ap-tech/Drivetrain/Drivetrain pics/323344108_1329896334519297_8781815676884146256_n.jpg

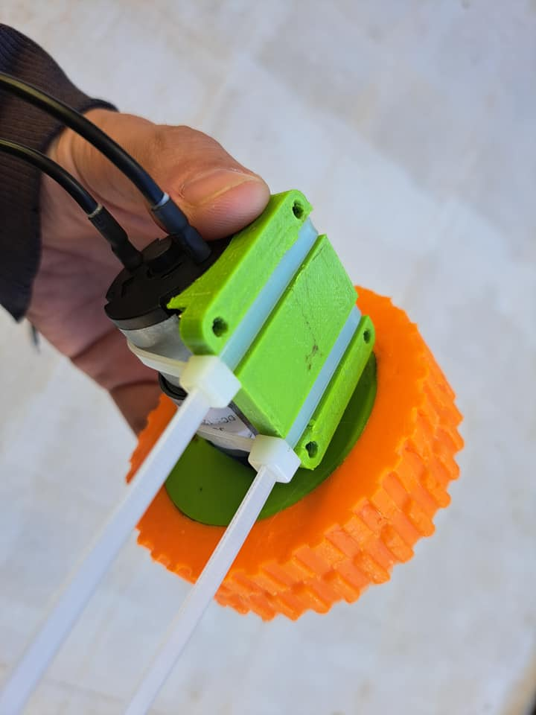
Drivetrain pics/323344108_1329896334519297_8781815676884146256_n.jpg
