ap-tech/Drivetrain/Drivetrain pics/325758844_697571495158825_5226416326378627529_n.jpg

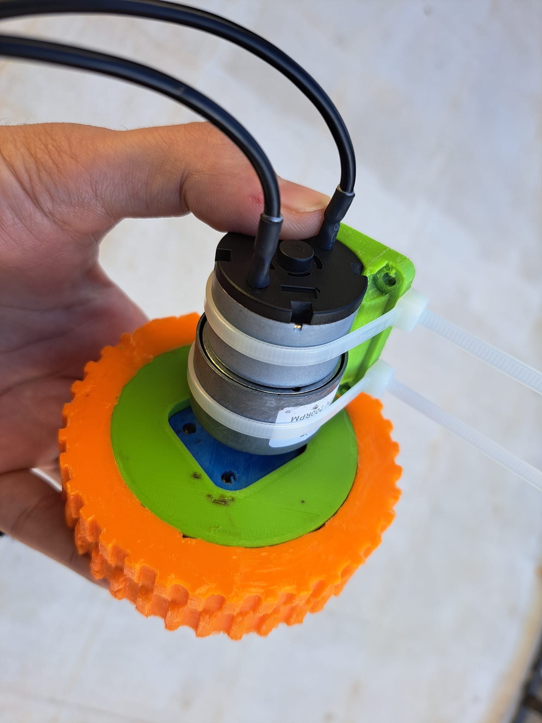
Drivetrain pics/325758844_697571495158825_5226416326378627529_n.jpg
