ap-tech/Drivetrain/Slicer settings and part orientation pics/Cor_Cap.jpg

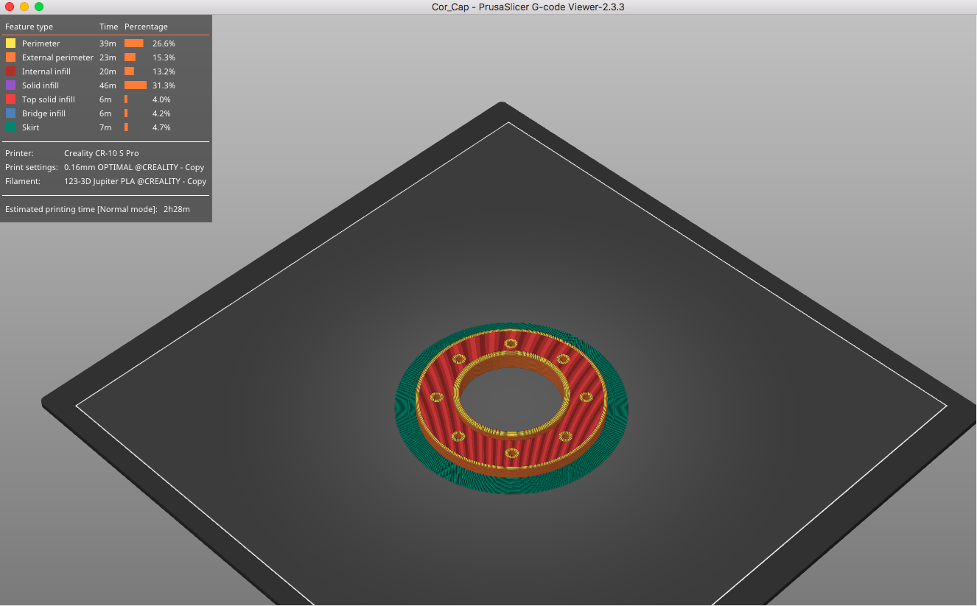
Slicer settings and part orientation pics/Cor_Cap.jpg
