ap-tech/Drivetrain/Slicer settings and part orientation pics/Coupling.jpg

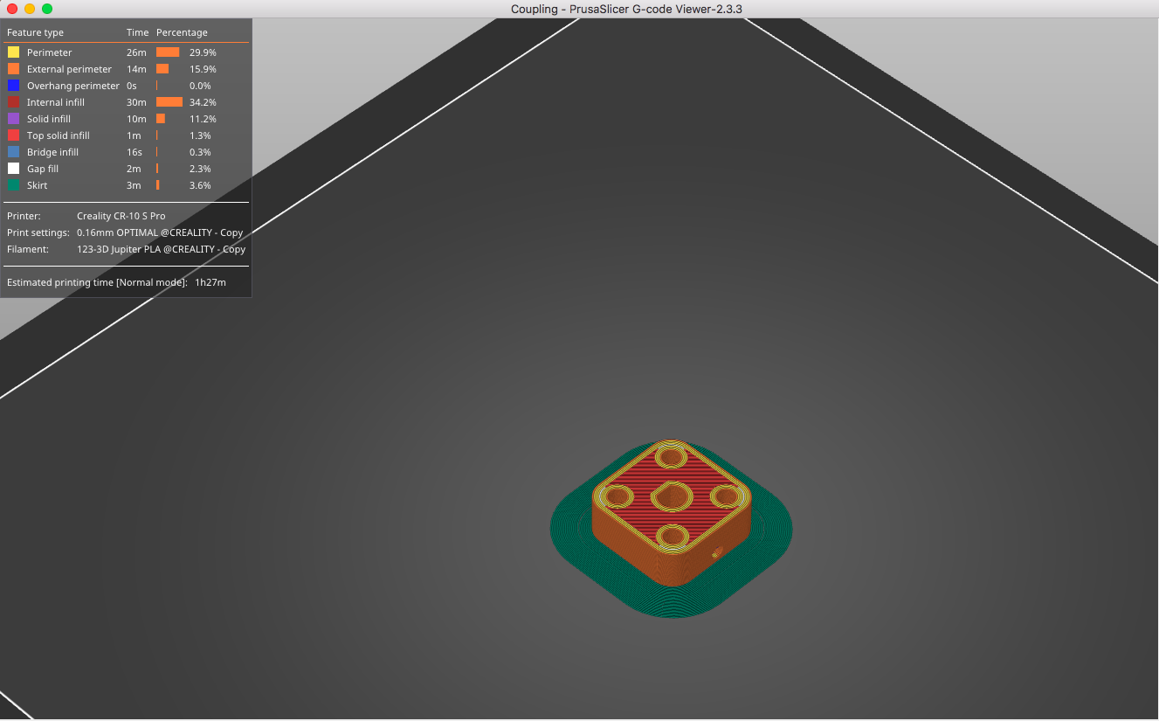
Slicer settings and part orientation pics/Coupling.jpg
