ap-tech/Drivetrain/Slicer settings and part orientation pics/Mold_B.jpg

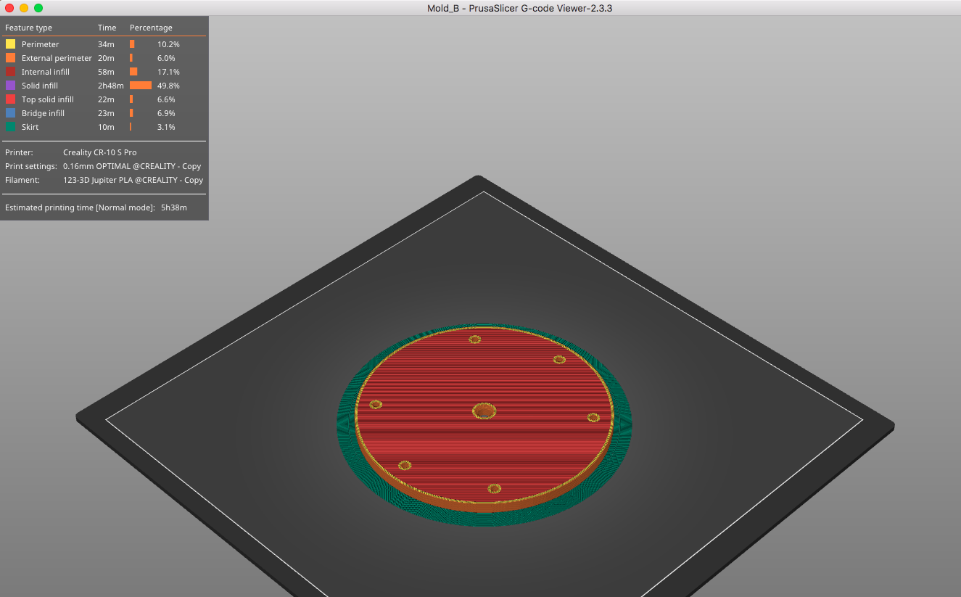
Slicer settings and part orientation pics/Mold_B.jpg
