ap-tech/Drivetrain/Slicer settings and part orientation pics/Mold_Cor.jpg

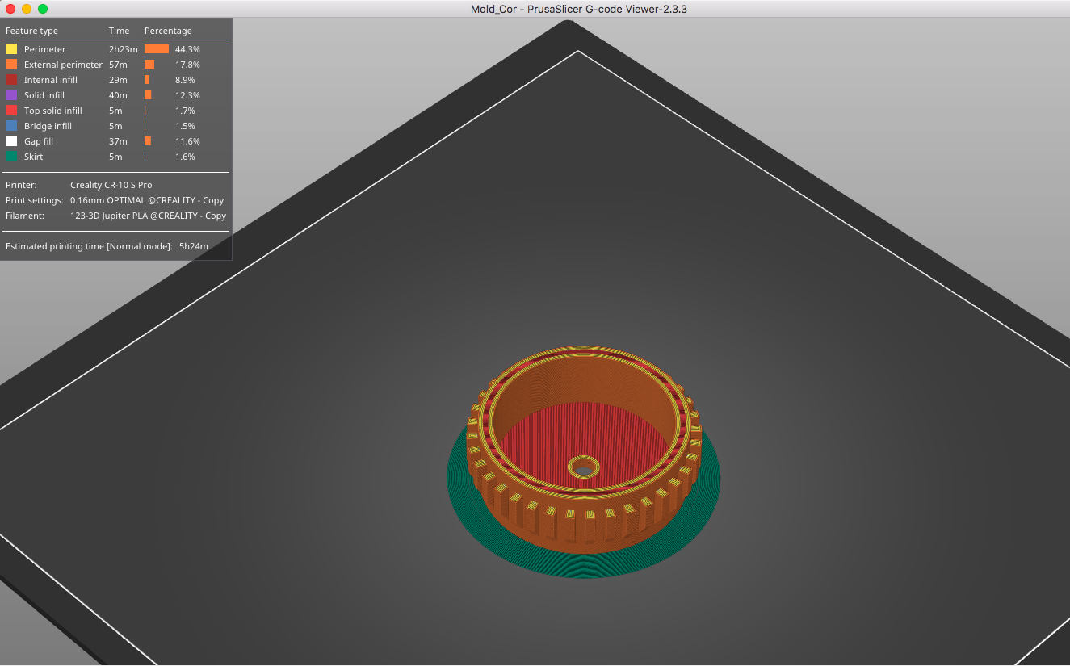
Slicer settings and part orientation pics/Mold_Cor.jpg
