ap-tech/Drivetrain/Slicer settings and part orientation pics/PrusaSlicer_1.jpg

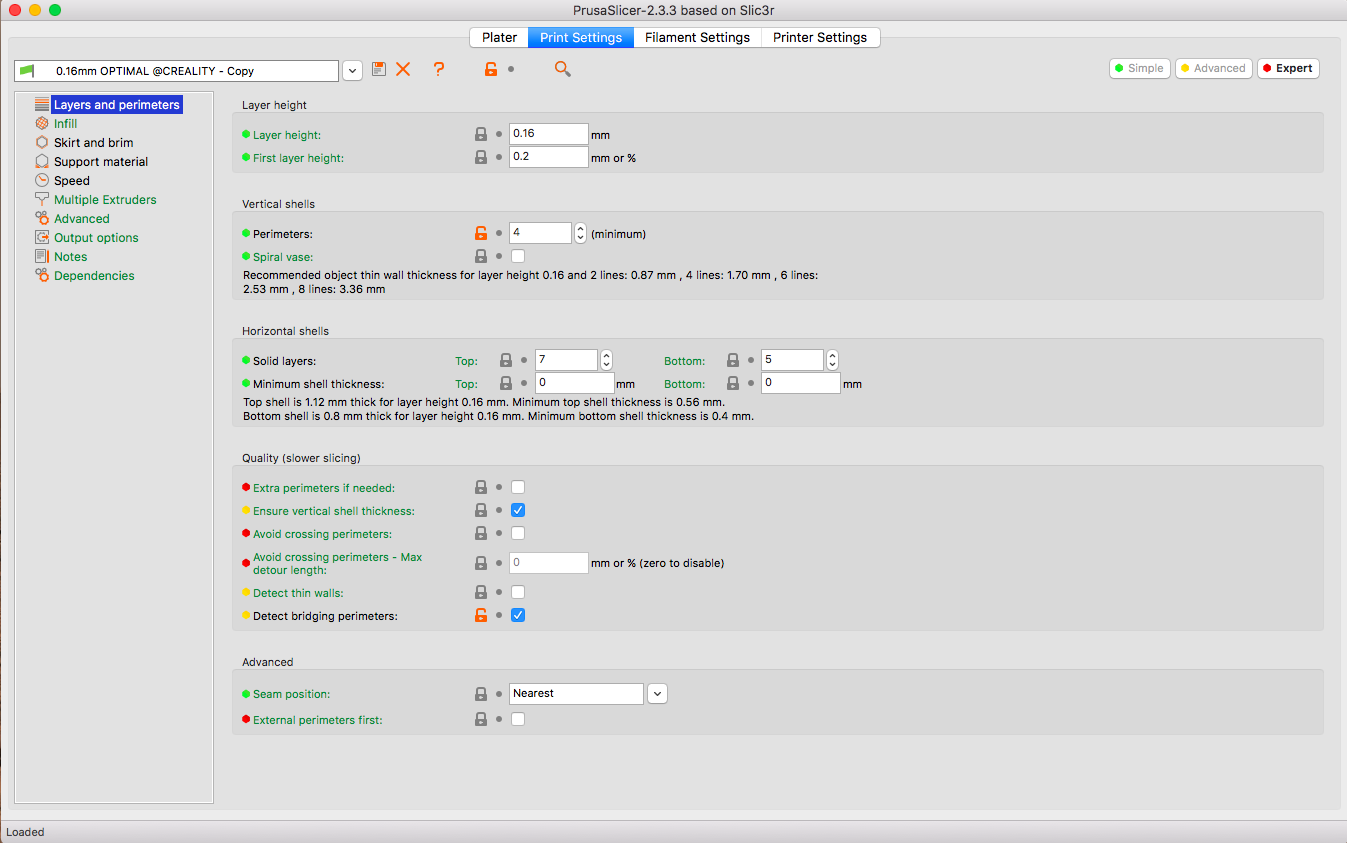
Slicer settings and part orientation pics/PrusaSlicer_1.jpg
