ap-tech/Drivetrain/Slicer settings and part orientation pics/PrusaSlicer_2.jpg

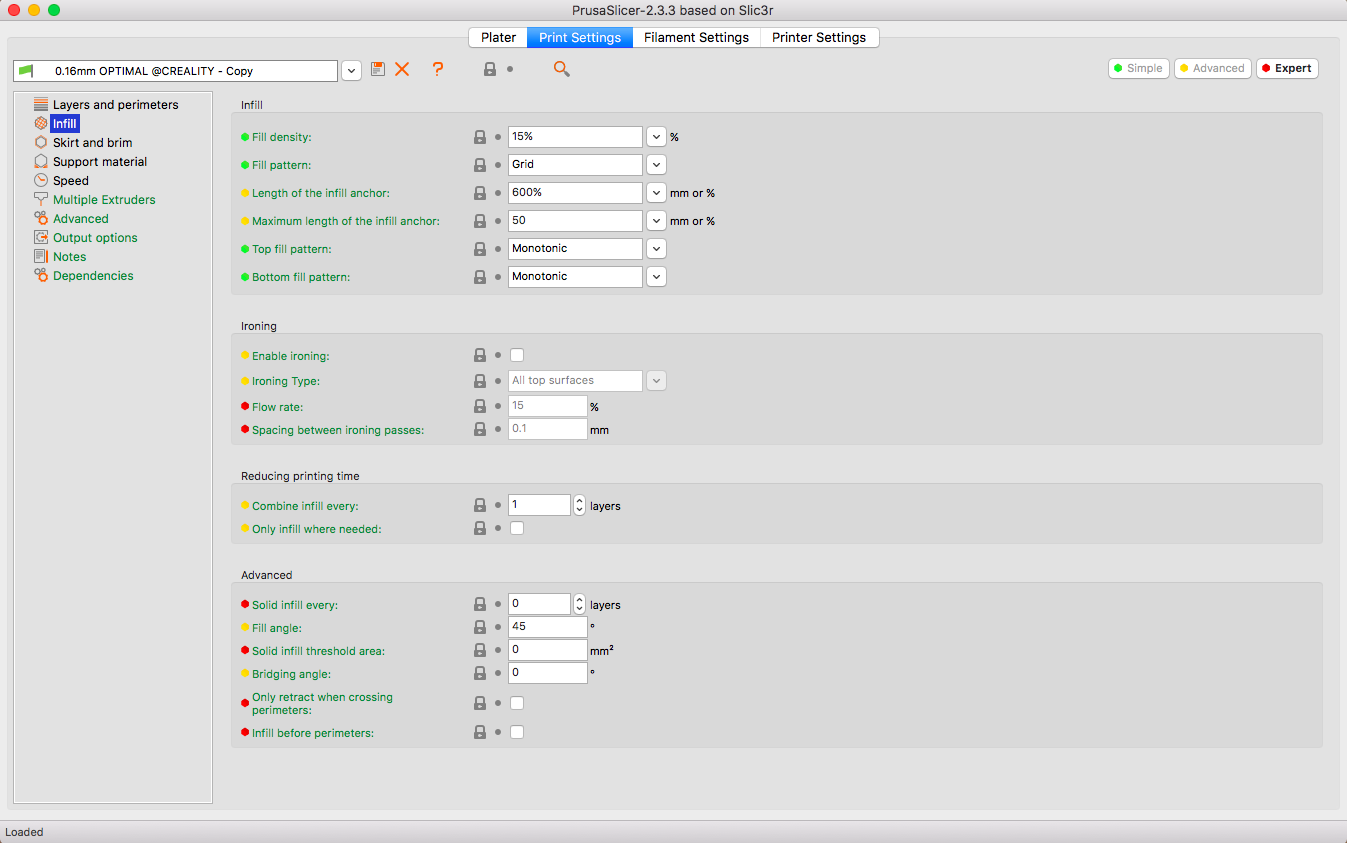
Slicer settings and part orientation pics/PrusaSlicer_2.jpg
