ap-tech/Drivetrain/Slicer settings and part orientation pics/PrusaSlicer_3.jpg

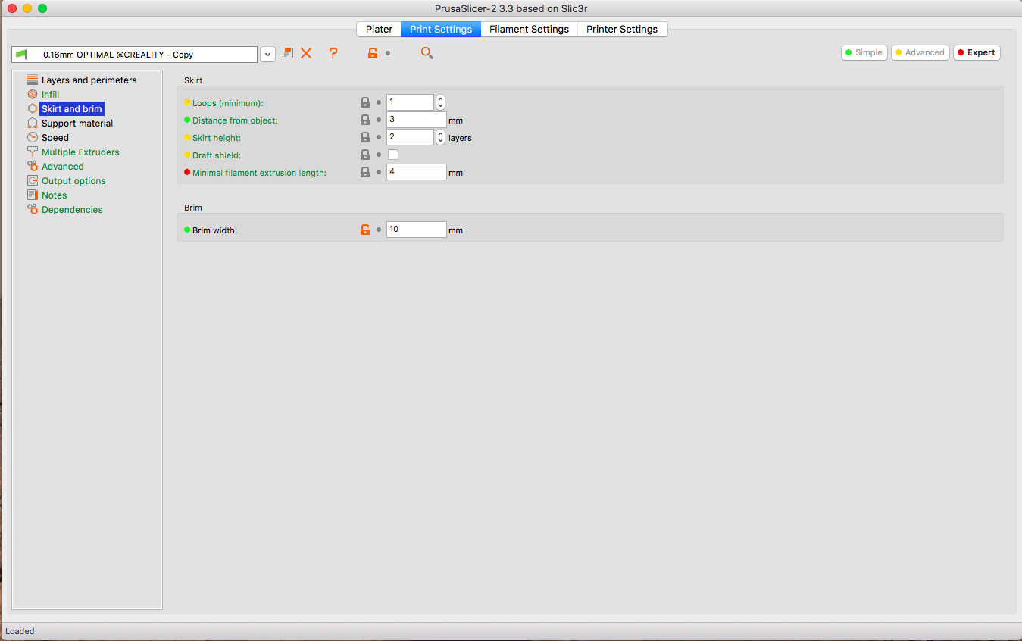
Slicer settings and part orientation pics/PrusaSlicer_3.jpg
