ap-tech/Drivetrain/Slicer settings and part orientation pics/PrusaSlicer_4.jpg

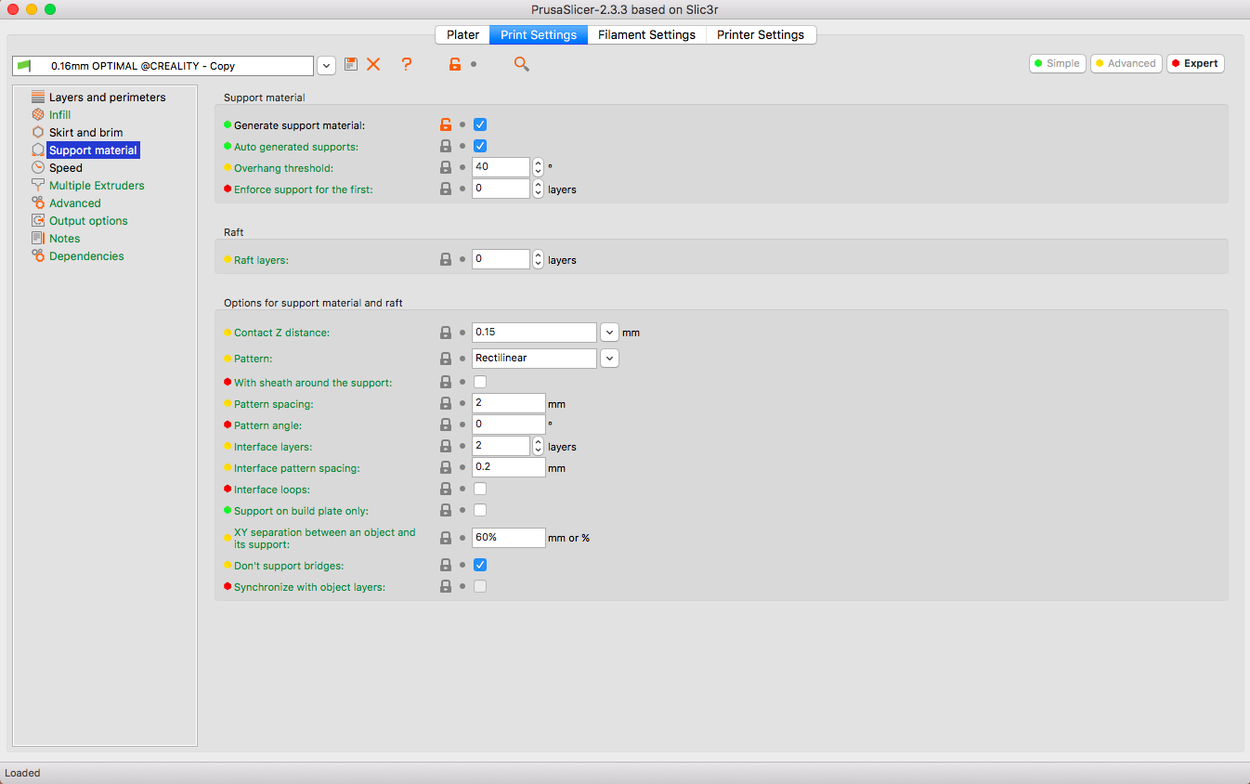
Slicer settings and part orientation pics/PrusaSlicer_4.jpg
