ap-tech/Drivetrain/Slicer settings and part orientation pics/PrusaSlicer_5.jpg

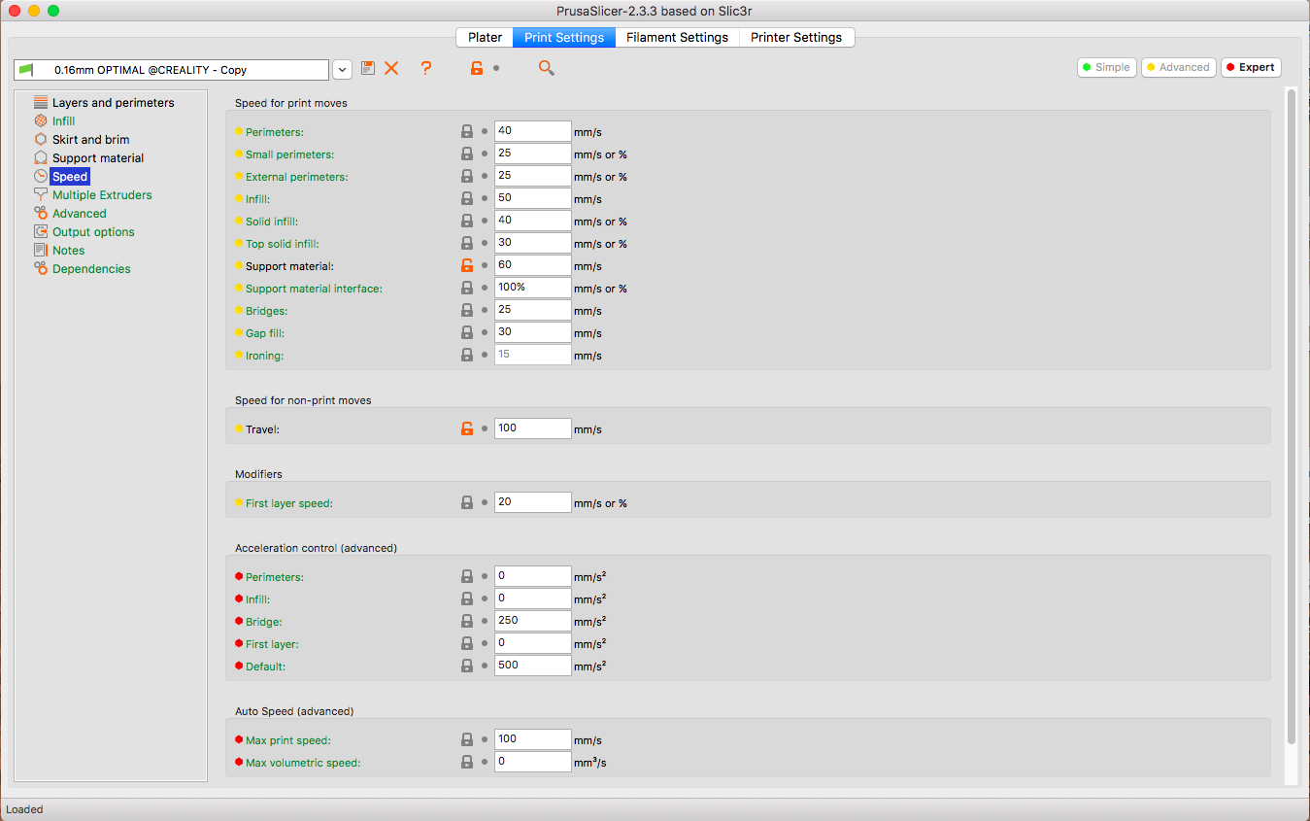
Slicer settings and part orientation pics/PrusaSlicer_5.jpg
