ap-tech/Drivetrain/Slicer settings and part orientation pics/Tyre_Tread.jpg

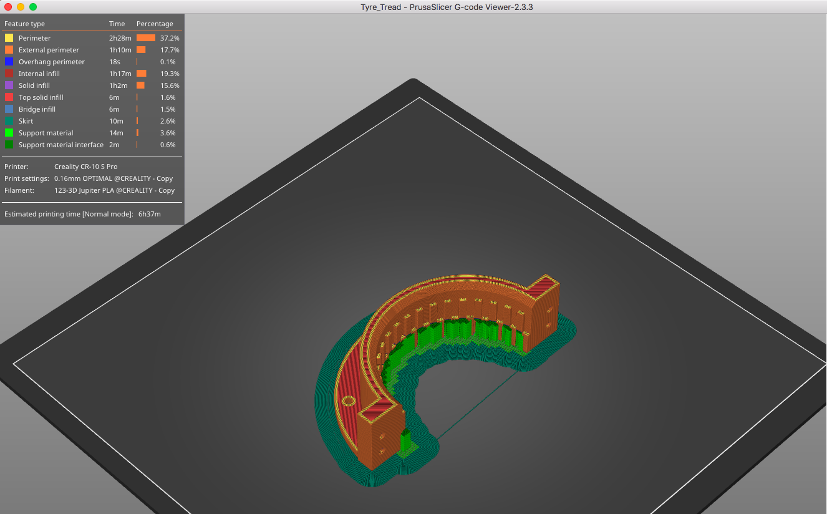
Slicer settings and part orientation pics/Tyre_Tread.jpg
