ap-tech/Drivetrain/Slicer settings and part orientation pics/Wheel.jpg

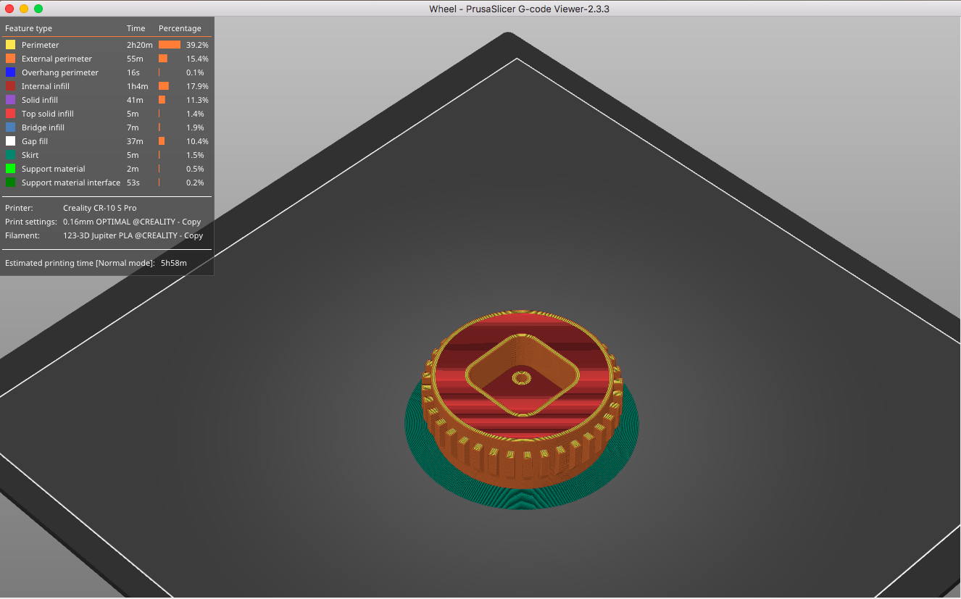
Slicer settings and part orientation pics/Wheel.jpg
