ap-tech/Drivetrain/Drivetrain stuff/Motor_Mt.stl

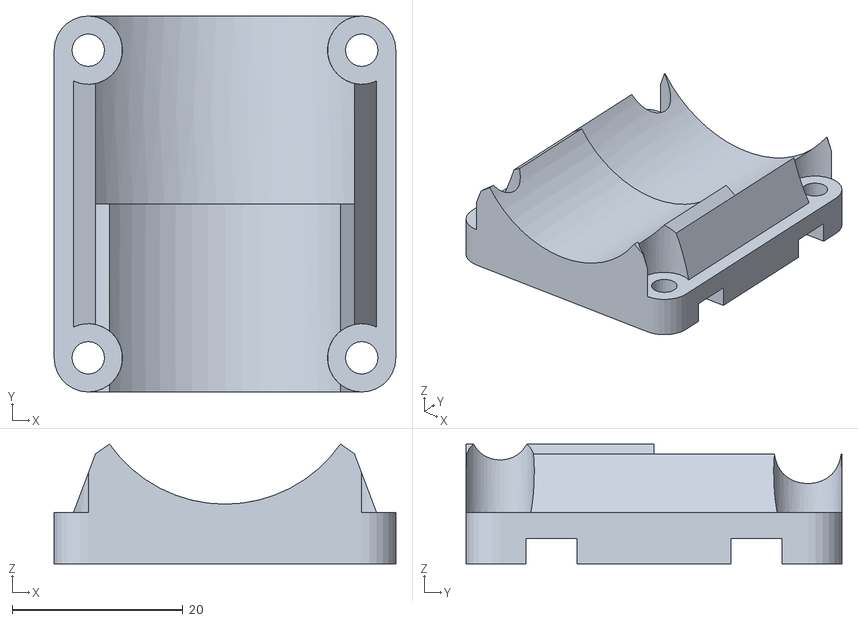
[picture p14: CAD file, 2023-02-28]
Drivetrain stuff/Motor_Mt.stl
40.0 x 44.0 x 14.0
