ap-tech/Drivetrain/Tyre mold stuff/Tyre_Tread.stl

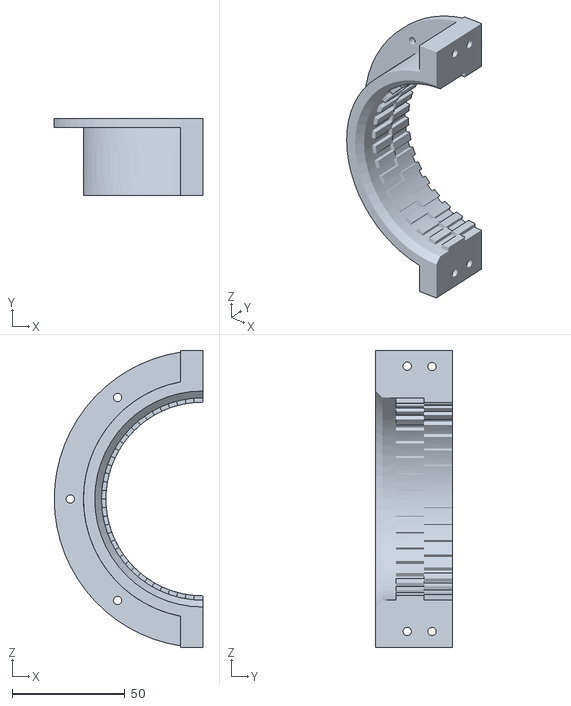
[picture p15: CAD file, 2023-02-22]
Tyre mold stuff/Tyre_Tread.stl
66.0 x 34.0 x 132.0
