ap-tech/Drivetrain/Drivetrain stuff/Coupling.stl

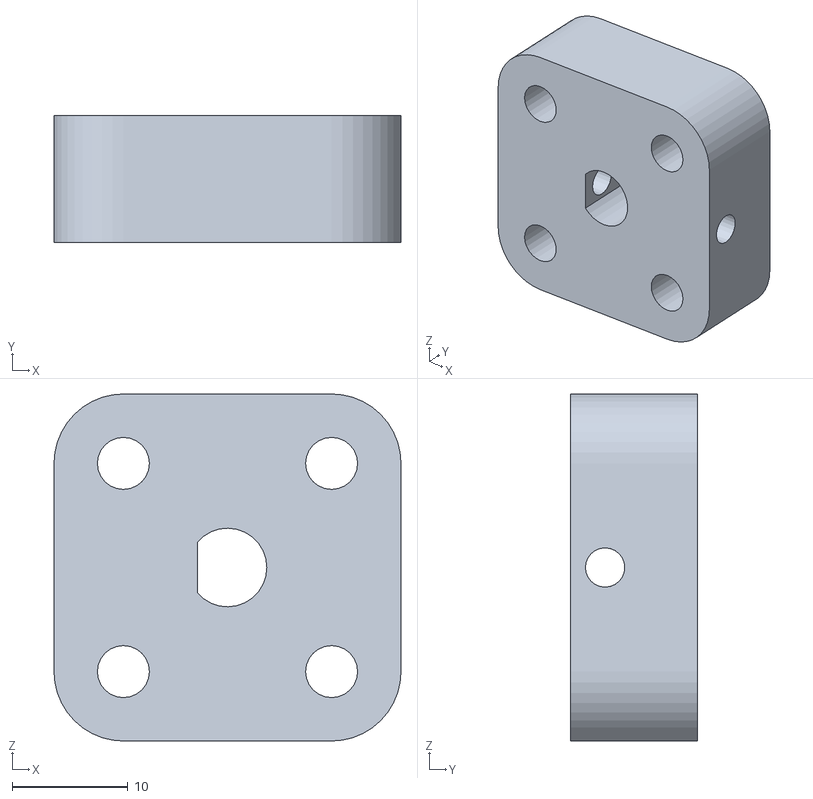
[picture p16: CAD file, 2023-02-22]
Drivetrain stuff/Coupling.stl
30.0 x 11.0 x 30.0
