ap-tech/Drivetrain/Tyre mold stuff/Mold_Cor.stl

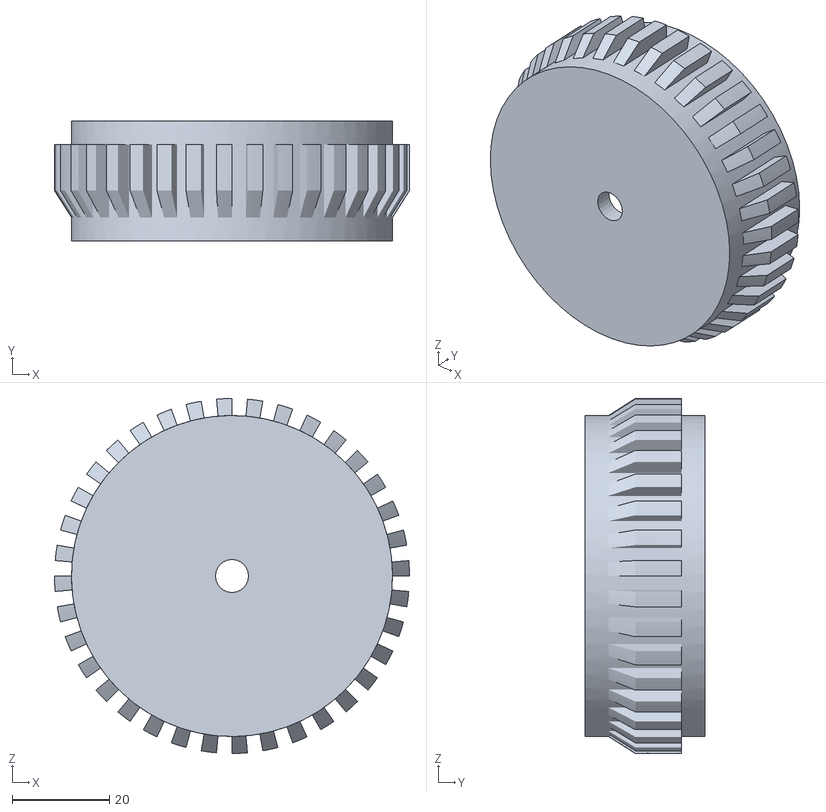
[picture p17: CAD file, 2023-02-22]
Tyre mold stuff/Mold_Cor.stl
73.0 x 24.7 x 73.0
