ap-tech/Drivetrain/Drivetrain stuff/Wheel.stl

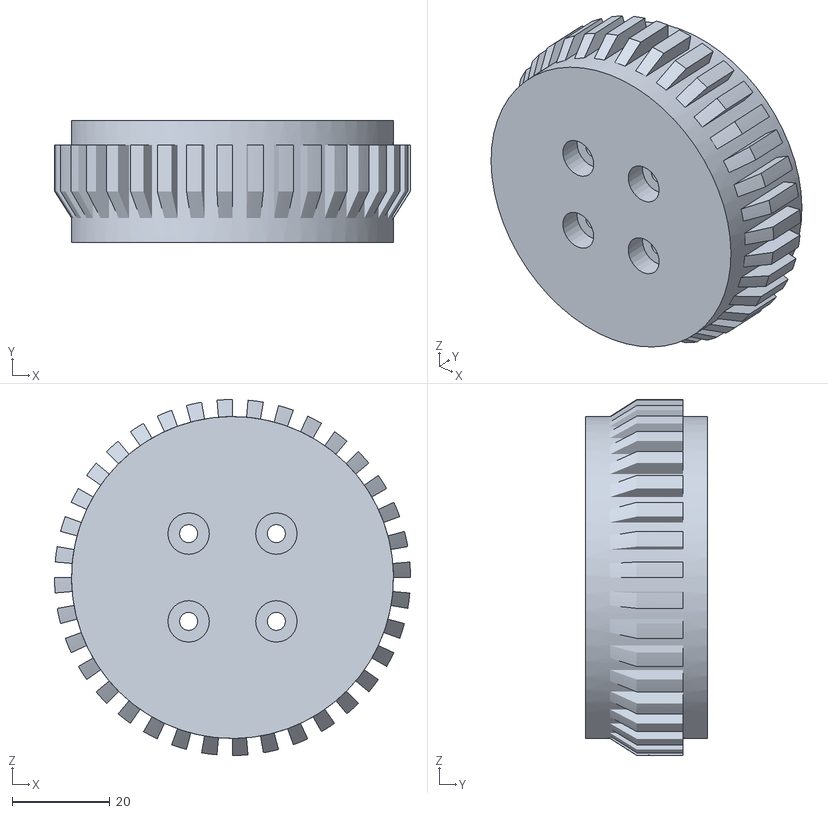
[picture p18: CAD file, 2023-02-22]
Drivetrain stuff/Wheel.stl
73.0 x 25.0 x 73.0
