ap-tech/Drivetrain/Tyre mold stuff/Cor_Cap.stl

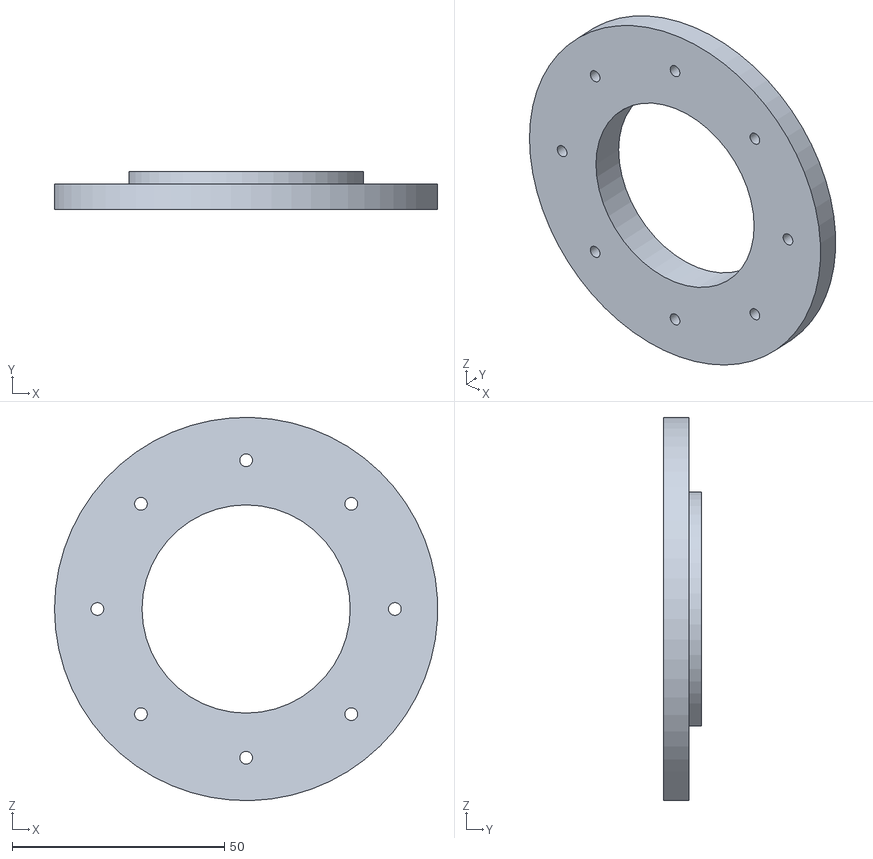
[picture p19: CAD file, 2023-02-22]
Tyre mold stuff/Cor_Cap.stl
90.1 x 9.00 x 90.2
