ap-tech/Drivetrain/Tyre mold stuff/Mold_B.stl

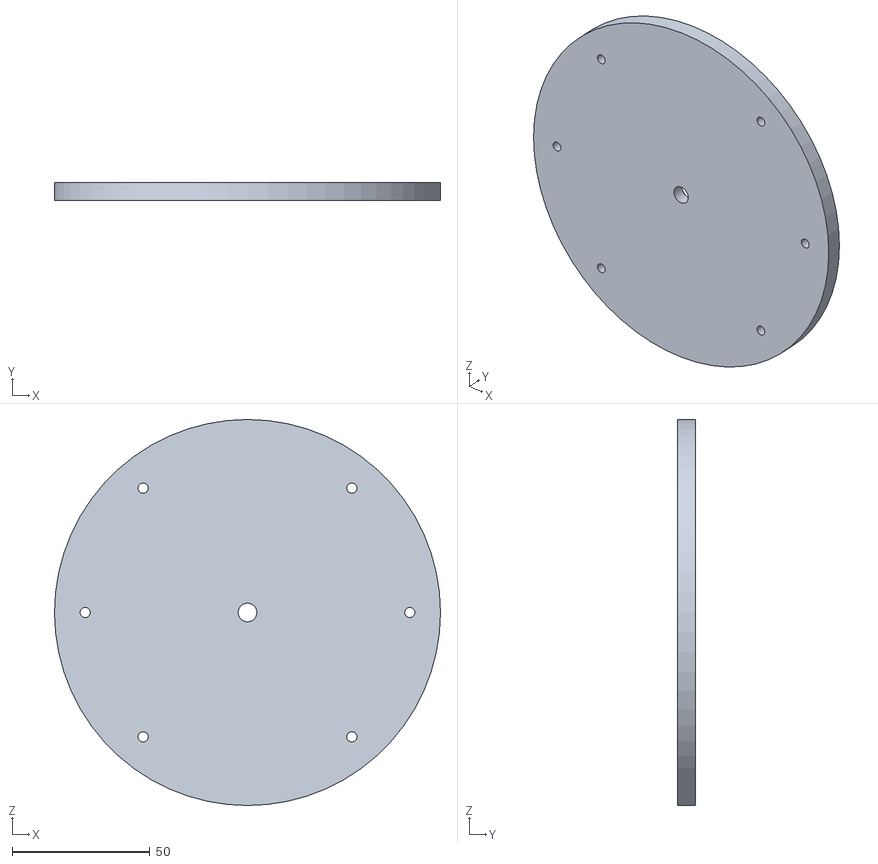
[picture p20: CAD file, 2023-02-22]
Tyre mold stuff/Mold_B.stl
140.0 x 6.50 x 140.0
