ap-tech/Drivetrain/(list of files, cad)

Other CAD files:
Drivetrain stuff/Coupling.f3d
Drivetrain stuff/Motor_Mt.f3d
Drivetrain stuff/Wheel.f3d
Tyre mold stuff/Cor_Cap.f3d
Tyre mold stuff/Mold_B.f3d
Tyre mold stuff/Mold_Cor.f3d
Tyre mold stuff/Tyre_Tread.f3d
