ap-tech/Drivetrain/Tyre mold stuff/Tyre Making.pdf

# Tyre Making

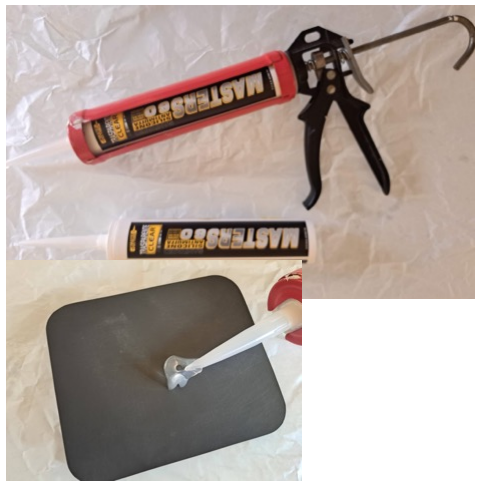
[picture p21: figure]

First thing you will need is pure transparent silicone not the white one not the black one or the one with additives in it to make it stronger but pure transparent silicone.

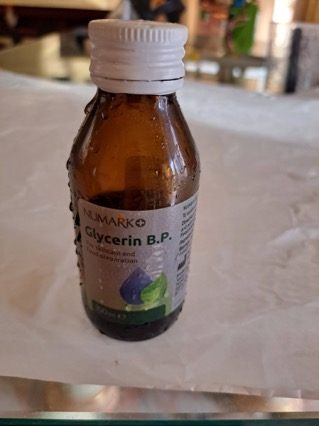
[picture p22: figure]

Glycerin, You can find this stuff at your local pharmacy and it is used as the hardener or kicker in this mix.

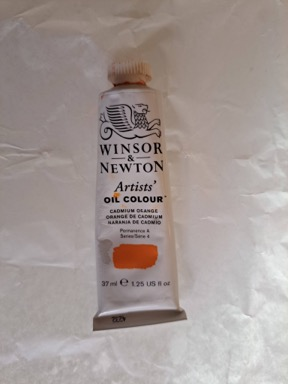
[picture p23: figure]

Oil colour, This is just to make my tyres orange, You can use any colour you want.

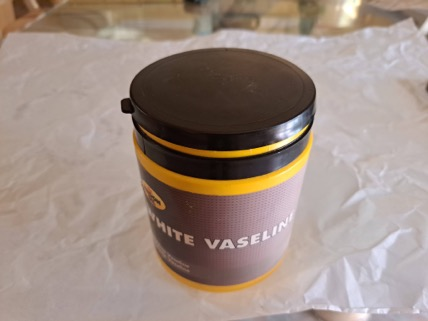
[picture p24: figure]

Vaseline, This will be your mould release.

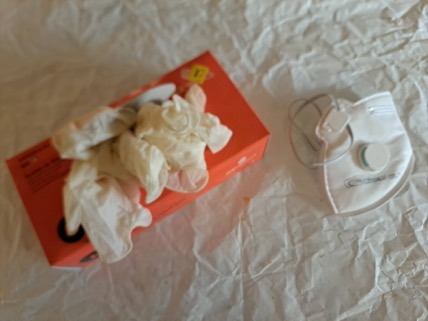
[picture p25: figure]

Gloves and disposable masks for chemicals

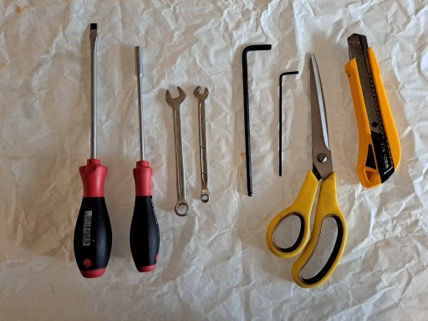
[picture p26: figure]

Tools, The most important ones here being 5.5mm socket screw driver (because there are parts on the moulds you just can’t reach with normal spanners) 5 and a 2.5mm hex keys and a 10mm spanner.

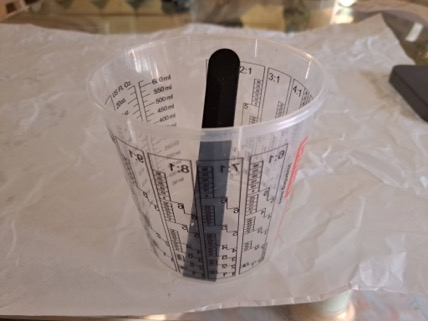
[picture p27: figure]

Mixing cup and mixing stick.

Plumbing tread tape and hex type fasteners For each mould.

1pc | 6x30mm bolt
4pc | 3x30mm bolts
6pc | 3x16mm bolts
1pc | 6mm nut
10pc 3mm nuts
2pc 6x40mm penny washer
20pc 3mm washers

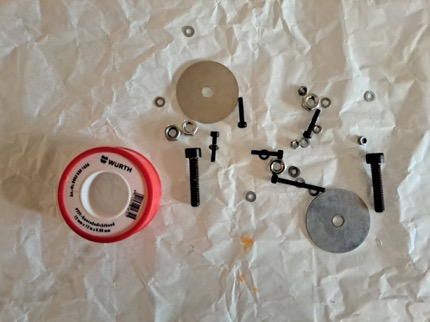
[picture p28: figure]

Next you are going to have to go to https://github.com/ap-tech/Drivetrain/tree/main/Tyre%20mold%20stuff and download the STLs for the mould parts, Now I’m assuming (https://github.com/ap-tech/Drivetrain/tree/main/Tyre%20mold%20stuff) that you are experienced with 3D printing so there is no 3D printing information here only moulding, There is that kind of info in https://github.com/ap-tech/Drivetrain/tree/main/Tyre%20mold%20stuff and in the https://github.com/ap-tech/Drivetrain/tree/main/

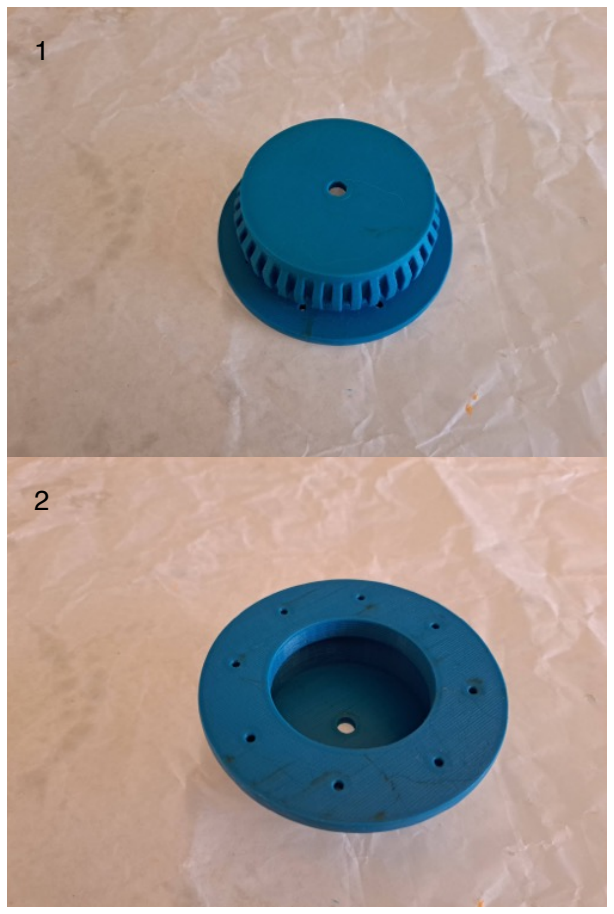
[picture p29: figure]

Pic 1 and pic 2 are the same item and are made by sticking Mold_Cor.stl and Cor_Cap.stl together with superglue, Cor_Cap has an indexing lip that fits inside Mold_Cor.stl

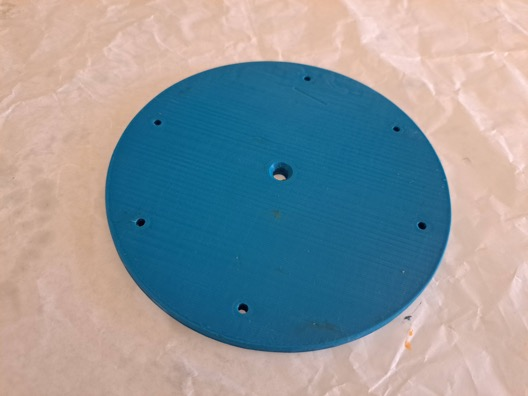
[picture p30: figure]

Gat 1 Mold_B.stl

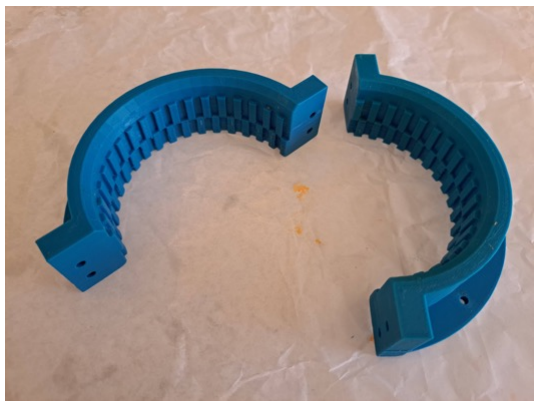
[picture p31: figure]

Get 2 of the Tyer_Tread.stl

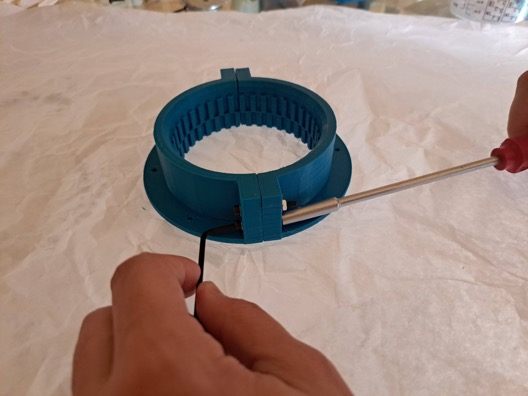
[picture p32: figure]

Put the 2 Tyer_Tread.stl pieces together with the 3x30mm bolts 3mm washers on both sides and the 3mm nuts.

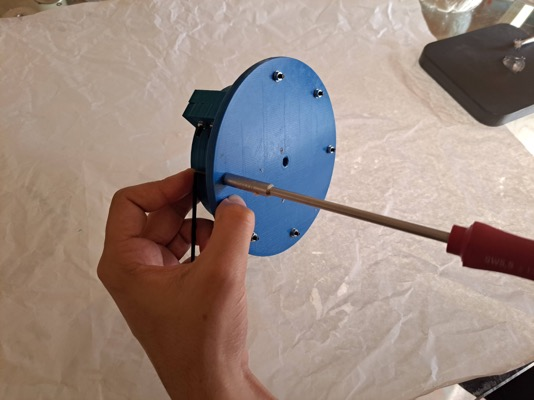
[picture p33: figure]

Attach Mold_B.stl to the 2 Tyer_Tread.stl pieces using the 3x16mm bolts, 3mm washers on both sides, And the 3mm nuts, Note the side with the draft on the middle hole goes on the inside, The draft is there to help the 6x40mm bolt index better.

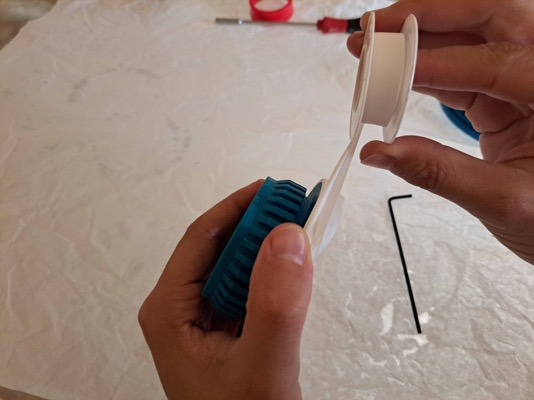
[picture p34: figure]

Put the plumber’s thread tape on the edge of this part, Try to keep the tape off the bottom of the plate where the tyre will be, Keep it to one side, This can be a bit tricky.

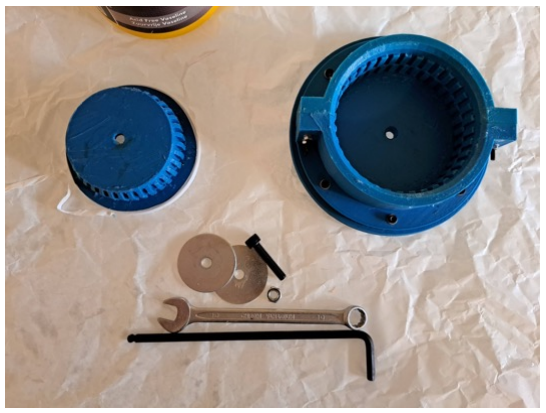
[picture p35: figure]

Then using a brush you are gonna cover the inside of the big part and the outside of the smaller one with the vaseline which will act as your mould release, Also prepare the 6x30mm bolt, The 6x40 penny washer, The 6mm nut, The 5mm hex key and the 10mm spanner.

Now we are gonna start the silicone mix, You have to be a bit fast for this one because once you mix the glycerin with the silicone the reaction starts, Now the mix is not an exact science so you are gonna hear me use terms like “presses” this is one complete press on the silicone gun handle, Your silicone gun may be completely different or your silicone may be in a tube, Some experimentation may be needed on your side.

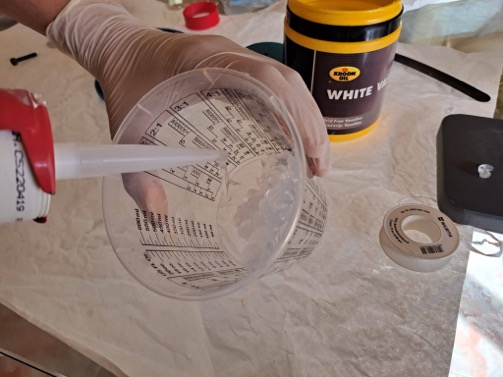
[picture p36: figure]

Put 5-7 presses of silicone in the mixing cup, Now again the amount depends on your equipment 5-6 presses work for me.

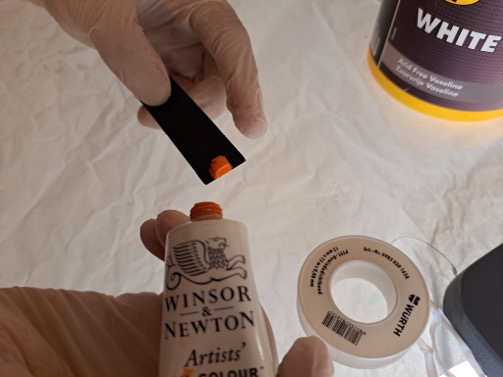
[picture p37: figure]

Put a small dab of the oil paint on the mixing stick what you see there is all you need.

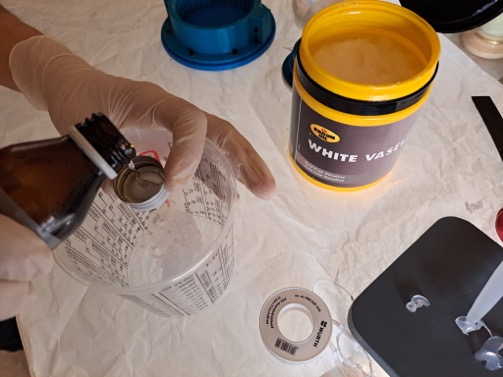
[picture p38: figure]

I’m using the tap of the glycerin bottle here to measure the amount of glycerin, Again not an exact science, All you need to know is that you need very little of it in the mix and that when you add start mixing immediately using the mixing stick with the oil paint on it.

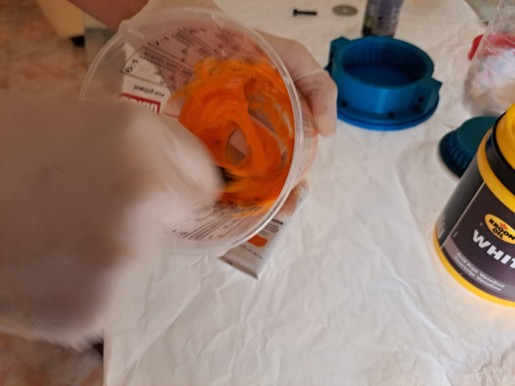
[picture p39: figure]

As you can see it goes completely orange with that dab of paint, Make sure that it is mixed well.

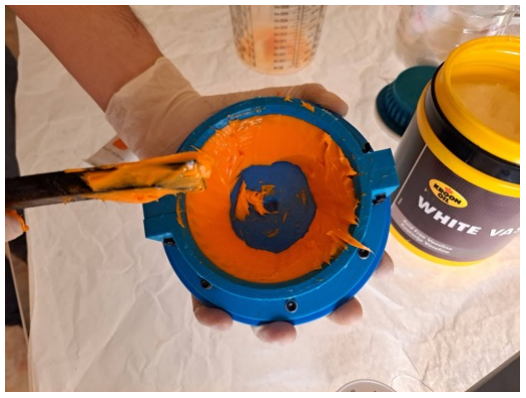
[picture p40: figure]

Than using the mixing stick you are going to plaster this stuff on the inside of the mould like what you see in the pic here, Try to make it even and press it in well, Use all of the content of the mixing cup.

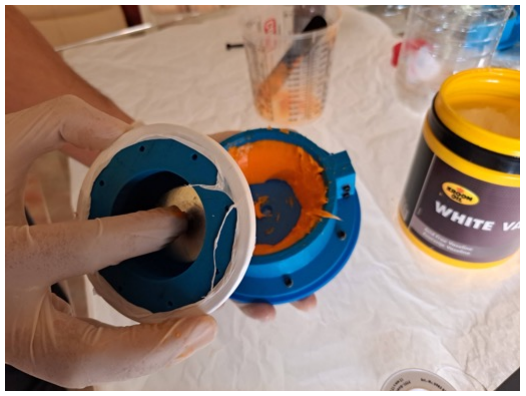
[picture p41: figure]

Put the 6x30 bold and the 6x40 washer in the top part of the mould and bring them together as you try to a line the bolt to the hole in the bottom of the mould.

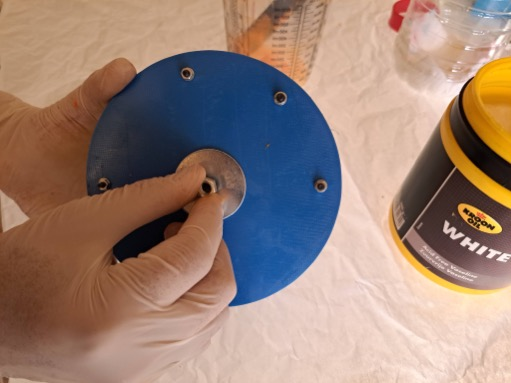
[picture p42: figure]

Close the bolt of from the other side with the 6x40mm washer and the 6mm nut, The washers are very important since you are going to be applying a lot of pressure on 15% infill 3D printed plastic.

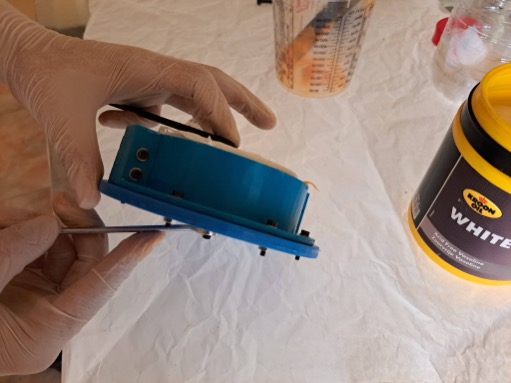
[picture p43: figure]

Using the 5mm hex key and the 10mm spanner start tightening until you feel that the 2 sides of the mould have met.

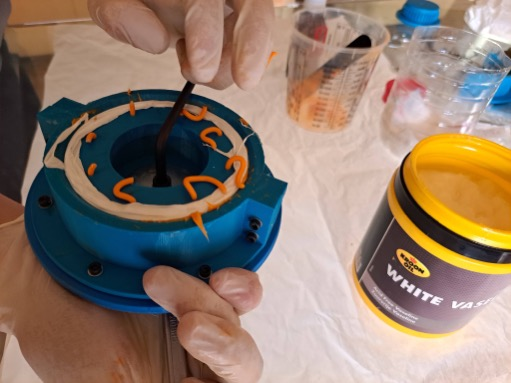
[picture p44: figure]

The mix should only come out of the 8 holes like this, Which is why I applied the plumber’s thread tape on the edge of the core piece.

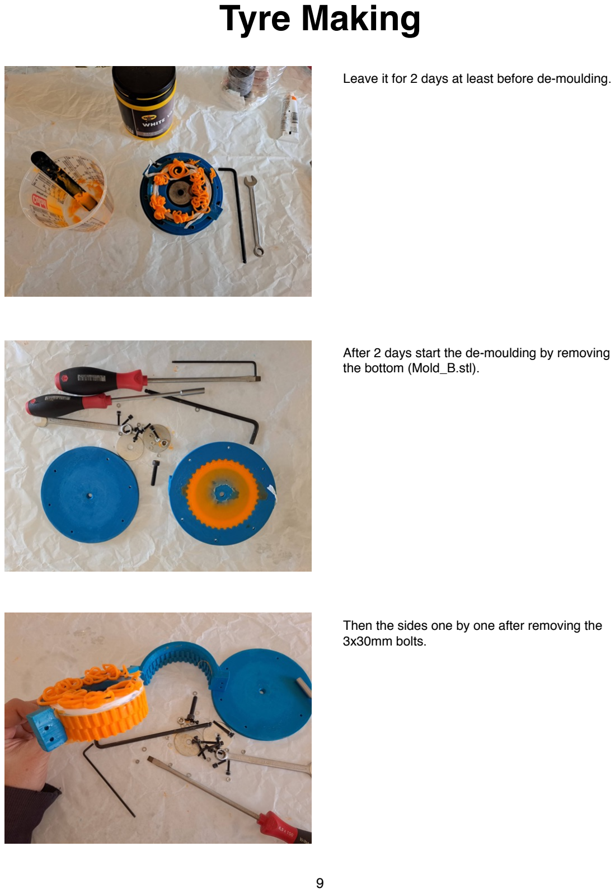
[picture p45: page 9]

Leave it for 2 days at least before de-moulding.

After 2 days start the de-moulding by removing the bottom (Mold_B.stl).

Then the sides one by one after removing the 3x30mm bolts.

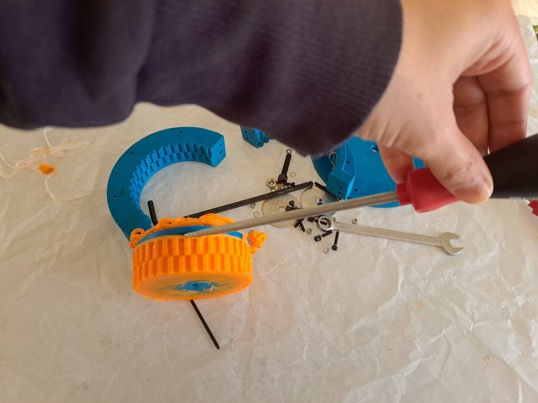
[picture p46: figure]

Then using something thin (In this case a flat head screwdriver) pry the tyre away from the mould’s core.

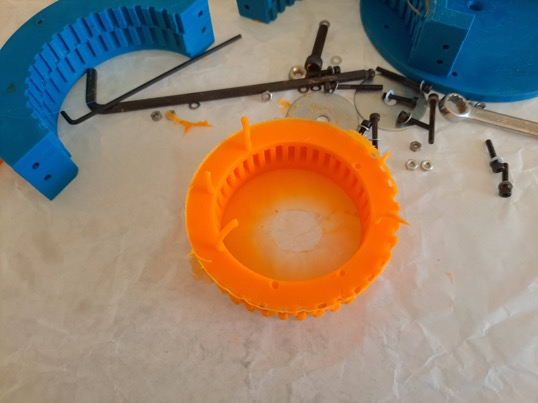
[picture p47: figure]

And you should end up with this, Leave it to settle for about 3 days after which the vinegar smell would have stoped emitting from it, And it would have stoped sweating the glycerin (ideal if you want to glue this material).

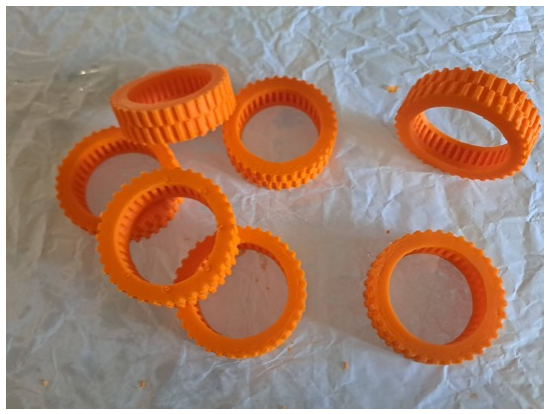
[picture p48: figure]

Than after 3 days trim the excess and rinse in warm soapy water, And you should end up with a cool looking tyre for your rover.

### Credit to my niece Emma Puglisevich

who at the time of 2023-02-26 was 6,

### She took the photos where both my

hands were occupied.

### Thanks Emma you Rock!
