ap-tech/Drivetrain/(commit log)

2023-02-22 Create Tyre mold stuff
2023-02-22 Create Drivetrain stuff
2023-02-22 Create Hole jig
2023-02-23 Create Drivetrain code
2023-02-23 Create Drivetrain pics
